BikeCookRobots/evil-red-button/cad/button-case_v03-case.stl

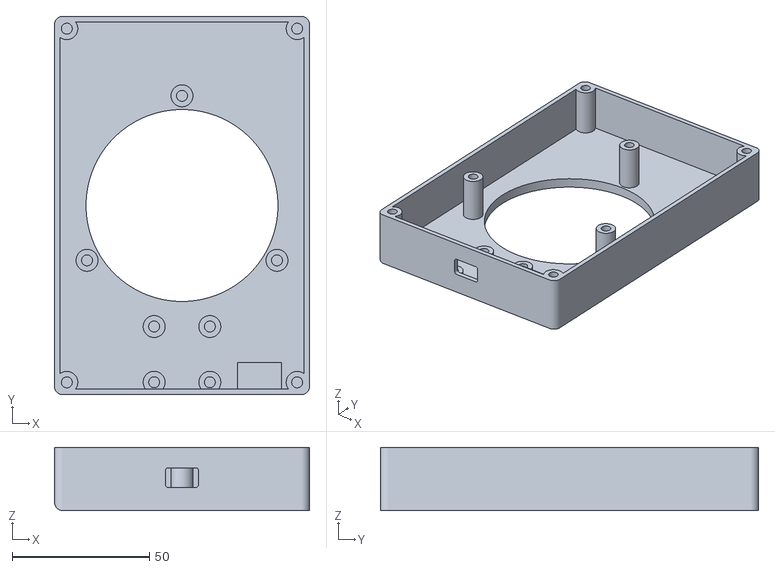
[picture p2: CAD file, 2025-06-25]
cad/button-case_v03-case.stl
93.0 x 138.0 x 23.0
