BikeCookRobots/evil-red-button/cad/button-case_v03-back.stl

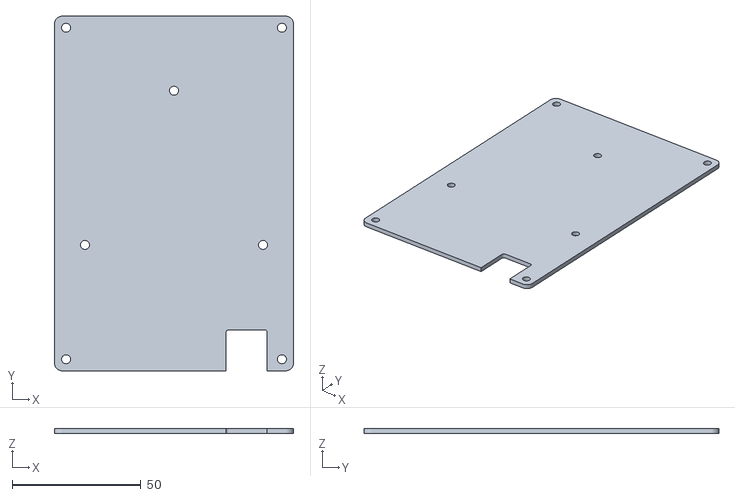
[picture p3: CAD file, 2025-06-25]
cad/button-case_v03-back.stl
93.0 x 138.0 x 2.00
