BikeCookRobots/evil-red-button/cad/button-case_v03-button backer.stl

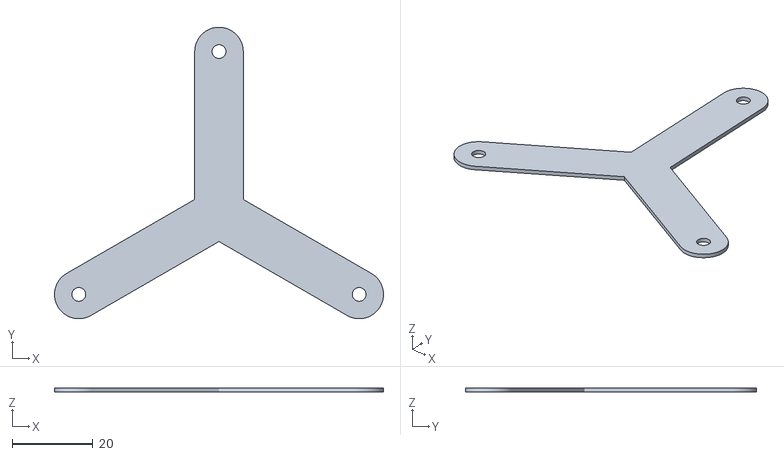
[picture p4: CAD file, 2025-06-25]
cad/button-case_v03-button backer.stl
81.3 x 72.0 x 1.00
