BikeCookRobots/evil-red-button/cad/button-case_v03-backSketch014.dxf

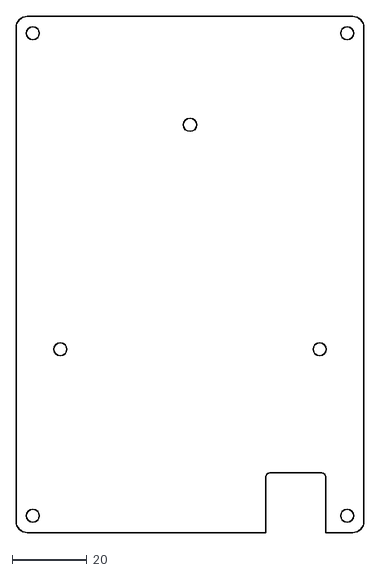
[picture p5: CAD file, 2025-06-25]
cad/button-case_v03-backSketch014.dxf
93.0 x 138.0
