BikeCookRobots/evil-red-button/cad/button-case_v03-button.stl

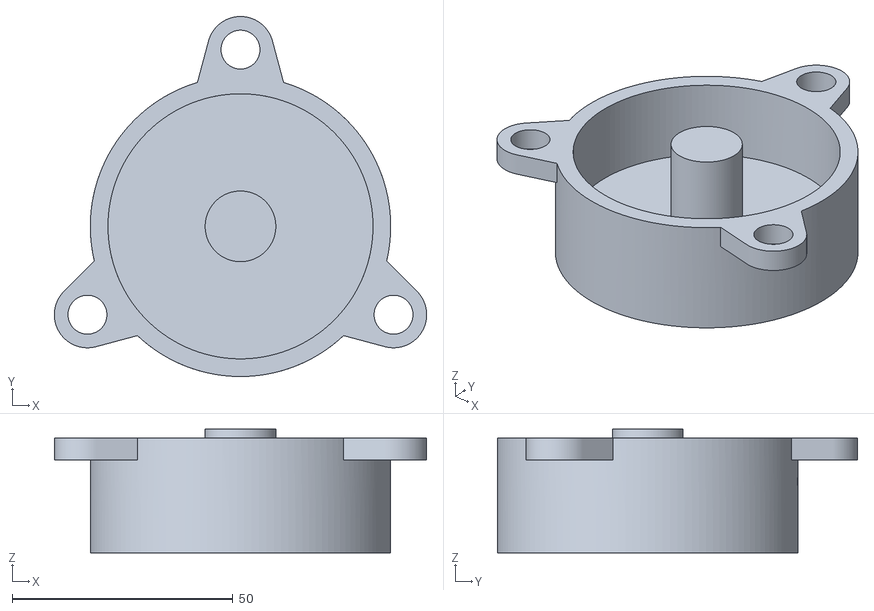
[picture p6: CAD file, 2025-06-25]
cad/button-case_v03-button.stl
84.3 x 81.5 x 28.0
