BikeCookRobots/evil-red-button/cad/button-case_v01-button.stl

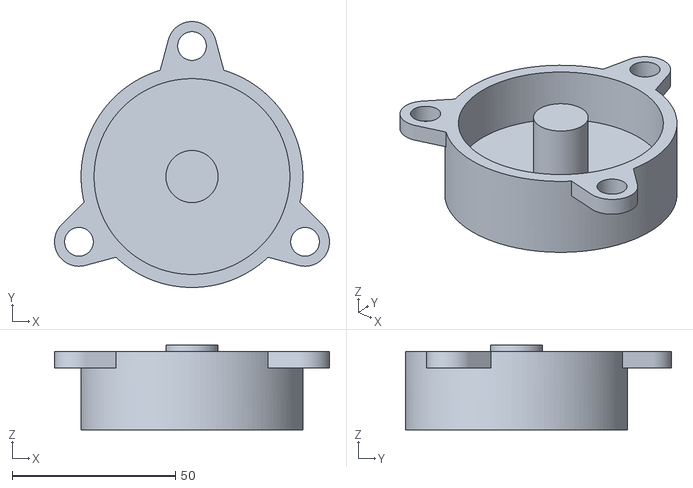
[picture p7: CAD file, 2025-05-06, an earlier design]
cad/button-case_v01-button.stl
84.3 x 81.5 x 26.0
