BikeCookRobots/evil-red-button/cad/button-case_v01-button backer.stl

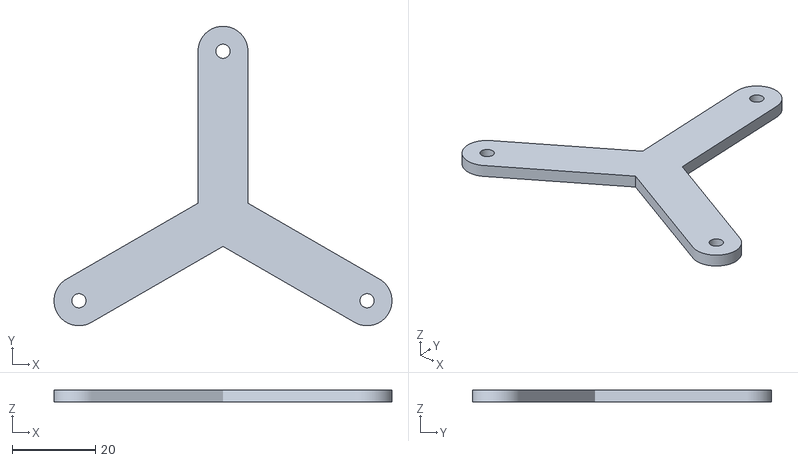
[picture p8: CAD file, 2025-05-06, an earlier design]
cad/button-case_v01-button backer.stl
81.3 x 72.0 x 3.00
