BikeCookRobots/evil-red-button/cad/button-case_v02-backSketch014.dxf

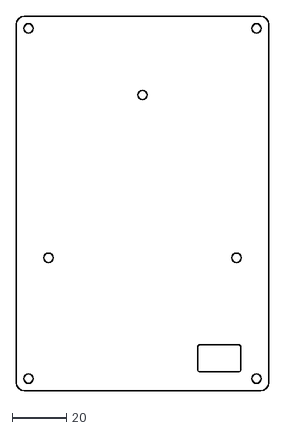
[picture p9: CAD file, 2025-05-06, an earlier design]
cad/button-case_v02-backSketch014.dxf
93.0 x 138.0
