BikeCookRobots/evil-red-button/(list of files, cad)

Other CAD files:
cad/button-case_v02-case.stl
